WTUGordon/Smart_Car/其他材料/获奖证书.jpg

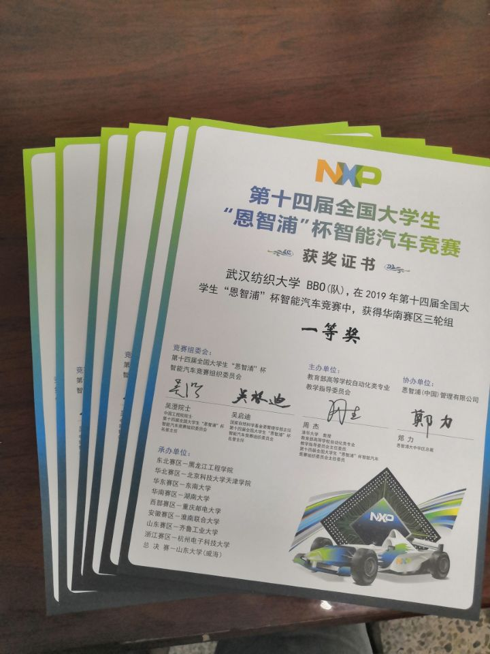
其他材料/获奖证书.jpg
