WTUGordon/Smart_Car/README.md

# Smart_Car
WTU BBO smart car 这个工程包括智能车的所有程序。
另外其他材料文件夹包括：材料清单、pcb原理图源文件、技术报告、获奖证书等。

BBO小队在恩智浦智能车第十四届比赛获得华南赛区一等奖。与国赛只相差一名，遗憾没能进入国赛。
