WTUGordon/Smart_Car/read me.txt

此工程模板由‘路径\... ...\山外K60参考代码V5.1（支持FX和DNZ）\第六章\DMA_鹰眼摄像头OV7725串口显示’ 更改。

App文件夹：存放着MK60的启动文件、总库、主函数、最底层驱动。不允许修改！
BBO文件夹：存放BBO写的头文件以及函数。
Board文件夹：存放所有外设硬件的驱动，有些是山外自带的，有些是从龙邱移植的。
Chip文件夹：存放K60单片机的所有功能模块的库，是野火山外的库。
Lib文件夹：内核头文件。
