WTUGordon/Smart_Car/Chip/src/MK66_i2c.c

/*!
 *     COPYRIGHT NOTICE
 *     Copyright (c) 2013,山外科技
 *     All rights reserved.
 *     技术讨论：山外论坛 http://www.vcan123.com
 *
 *     除注明出处外，以下所有内容版权均属山外科技所有，未经允许，不得用于商业用途，
 *     修改内容时必须保留山外科技的版权声明。
 *
 * @file       MK66_i2c.c
 * @brief      i2c驱动函数
 * @author     山外科技
 * @version    v6.0
 * @date       2013-07-12
 */

#include "common.h"
#include "MK66_port.h"
#include "MK66_i2c.h"
#include "include.h"

/*!
 *  @brief      I2C通信结束后需要调用的函数函数
 *  @since      v5.0
 *  @note       如果通信失败，可尝试增大此延时值，确认是否延时导致的
 */
void Pause(void)
{
    volatile uint16 n = 80;     //注意，这个数据太小，会导致读取错误。

    while(n--)
    {
        asm("nop");
    }
}

/******************************************************************************
*函  数：void delay_us(void)
*功　能：IIC延时
*参  数：无
*返回值：无
*备  注: 移植时只需要将delay_us()换成自己的延时即可
*******************************************************************************/
void delay_us(uint8_t us)
{
    for(int i = 0; i < 100; i++)
    {
        asm("NOP");//core bus 200M  情况下大概IIC速率 400K
    }
}

/******************************************************************************
*函  数：void IIC_Init(void)
*功　能：IIC初始化
*参  数：无
*返回值：无
*备  注：无
*******************************************************************************/
void IIC_Init(void)
{
    gpio_init(IIC_SCL_PIN,GPO,1);
    gpio_init(IIC_SDA_PIN,GPO,1);

	IIC_SCL=1;
	IIC_SDA=1;
}
/******************************************************************************
*函  数：void IIC_Start(void)
*功　能：产生IIC起始信号
*参  数：无
*返回值：无
*备  注：无
*******************************************************************************/
void IIC_Begin(void)
{
	SDA_O(); //sda线输出
	IIC_SDA=1;
	IIC_SCL=1;
	delay_us(4);
 	IIC_SDA=0; //START:when CLK is high,DATA change form high to low
	delay_us(4);
	IIC_SCL=0; //钳住I2C总线，准备发送或接收数据
}

/******************************************************************************
*函  数：void IIC_Stop(void)
*功　能：产生IIC停止信号
*参  数：无
*返回值：无
*备  注：无
*******************************************************************************/
void IIC_Cease(void)
{
	SDA_O(); //sda线输出
	IIC_SCL=0;
	IIC_SDA=0; //STOP:when CLK is high DATA change form low to high
    delay_us(4);
	IIC_SCL=1;
	IIC_SDA=1; //发送I2C总线结束信号
    delay_us(4);
}

/******************************************************************************
*函  数: uint8_t IIC_WaitAck(void)
*功　能: 等待应答信号到来 （有效应答：从机第9个 SCL=0 时 SDA 被从机拉低,
并且 SCL = 1时 SDA依然为低）
*参  数：无
*返回值：1，接收应答失败
0，接收应答成功
*备  注：从机给主机的应答
*******************************************************************************/
uint8_t IIC_WaitAck(void)
{
	uint8_t ucErrTime=0;
	SDA_I(); //SDA设置为输入  （从机给一个低电平做为应答）
	IIC_SDA=1;delay_us(1);
	IIC_SCL=1;delay_us(1);;
	while(READ_SDA)
	{
		ucErrTime++;
		if(ucErrTime>250)
		{
			IIC_Cease();
			return 1;
		}
	}
	IIC_SCL=0; //时钟输出0
	return 0;
}

/******************************************************************************
*函  数: void IIC_Ack(void)
*功　能: 产生ACK应答 （主机接收完一个字节数据后，主机产生的ACK通知从机一个
字节数据已正确接收）
*参  数：无
*返回值：无
*备  注：主机给从机的应答
*******************************************************************************/

void IIC_Ack(void)
{
	IIC_SCL=0;
	SDA_O();
	IIC_SDA=0;
	delay_us(1);
	IIC_SCL=1;
	delay_us(2);
	IIC_SCL=0;
}

/******************************************************************************
*函  数: void IIC_NAck(void)
*功　能: 产生NACK应答 （主机接收完最后一个字节数据后，主机产生的NACK通知从机
发送结束，释放SDA,以便主机产生停止信号）
*参  数：无
*返回值：无
*备  注：主机给从机的应答
*******************************************************************************/
void IIC_NAck(void)
{
	IIC_SCL=0;
	SDA_O();
	IIC_SDA=1;
	delay_us(1);
	IIC_SCL=1;
	delay_us(1);
	IIC_SCL=0;
}

/******************************************************************************
*函  数：void IIC_SendByte(uint8_t txd)
*功  能：IIC发送一个字节
*参  数：data 要写的数据
*返回值：无
*备  注：主机往从机发
*******************************************************************************/
void IIC_SendByte(uint8_t data)
{
    uint8_t t;
    SDA_O();
    IIC_SCL=0; //拉低时钟开始数据传输
    for(t=0;t<8;t++)
    {
        IIC_SDA=(data&0x80)>>7;
        data<<=1;
        delay_us(1);
        IIC_SCL=1;
        delay_us(1);
        IIC_SCL=0;
        delay_us(1);
    }
}

/******************************************************************************
*函  数：uint8_t IIC_ReadByte(uint8_t ack)
*功  能：IIC读取一个字节
*参  数：ack=1 时，主机数据还没接收完 ack=0 时主机数据已全部接收完成
*返回值：无
*备  注：从机往主机发
*******************************************************************************/
uint8_t IIC_ReadByte(uint8_t ack)
{
	uint8_t i,receive=0;
	SDA_I(); //SDA设置为输入模式 等待接收从机返回数据
    for(i=0;i<8;i++ )
	{
        IIC_SCL=0;
        delay_us(1);
        IIC_SCL=1;
        receive<<=1;
        if(READ_SDA)receive++; //从机发送的电平
        delay_us(1);
    }
    if(ack)
        IIC_Ack(); //发送ACK
    else
        IIC_NAck(); //发送nACK
    return receive;
}

/******************************************************************************
*函  数：uint8_t IIC_ReadByteFromSlave(uint8_t I2C_Addr,uint8_t addr)
*功　能：读取指定设备 指定寄存器的一个值
*参  数：I2C_Addr  目标设备地址
reg	     寄存器地址
*buf      读取数据要存储的地址
*返回值：返回 1失败 0成功
*备  注：无
*******************************************************************************/
uint8_t IIC_ReadByteFromSlave(uint8_t I2C_Addr,uint8_t reg,uint8_t *buf)
{
	IIC_Begin();
	IIC_SendByte(I2C_Addr);	 //发送从机地址
	if(IIC_WaitAck()) //如果从机未应答则数据发送失败
	{
		IIC_Cease();
		return 1;
	}
	IIC_SendByte(reg); //发送寄存器地址
	IIC_WaitAck();

	IIC_Begin();
	IIC_SendByte(I2C_Addr+1); //进入接收模式
	IIC_WaitAck();
	*buf=IIC_ReadByte(0);
    IIC_Cease(); //产生一个停止条件
	return 0;
}

/******************************************************************************
*函  数：uint8_t IIC_WriteByteFromSlave(uint8_t I2C_Addr,uint8_t addr，uint8_t buf))
*功　能：写入指定设备 指定寄存器的一个值
*参  数：I2C_Addr  目标设备地址
reg	     寄存器地址
buf       要写入的数据
*返回值：1 失败 0成功
*备  注：无
*******************************************************************************/
uint8_t IIC_WriteByteToSlave(uint8_t I2C_Addr,uint8_t reg,uint8_t data)
{
	IIC_Begin();
	IIC_SendByte(I2C_Addr); //发送从机地址
	if(IIC_WaitAck())
	{
		IIC_Cease();
		return 1; //从机地址写入失败
	}
	IIC_SendByte(reg); //发送寄存器地址
    IIC_WaitAck();
	IIC_SendByte(data);
	if(IIC_WaitAck())
	{
		IIC_Cease();
		return 1; //数据写入失败
	}
	IIC_Cease(); //产生一个停止条件

    //return 1; //status == 0;
	return 0;
}

/******************************************************************************
*函  数：uint8_t IICreadBytes(uint8_t dev, uint8_t reg, uint8_t length, uint8_t *data)
*功　能：读取指定设备 指定寄存器的 length个值
*参  数：dev     目标设备地址
reg	   寄存器地址
length  要读的字节数
*data   读出的数据将要存放的指针
*返回值：1成功 0失败
*备  注：无
*******************************************************************************/
uint8_t IIC_ReadMultByteFromSlave(uint8_t dev, uint8_t reg, uint8_t length, uint8_t *data)
{
    uint8_t count = 0;
	uint8_t temp;
	IIC_Begin();
	IIC_SendByte(dev); //发送从机地址
	if(IIC_WaitAck())
	{
		IIC_Cease();
		return 1; //从机地址写入失败
	}
	IIC_SendByte(reg); //发送寄存器地址
    IIC_WaitAck();
	IIC_Begin();
	IIC_SendByte(dev+1); //进入接收模式
	IIC_WaitAck();
    for(count=0;count<length;count++)
	{
		if(count!=(length-1))
            temp = IIC_ReadByte(1); //带ACK的读数据
		else
            temp = IIC_ReadByte(0); //最后一个字节NACK

		data[count] = temp;
	}
    IIC_Cease(); //产生一个停止条件
    //return count;
    return 0;
}

/******************************************************************************
*函  数：uint8_t IICwriteBytes(uint8_t dev, uint8_t reg, uint8_t length, uint8_t* data)
*功　能：将多个字节写入指定设备 指定寄存器
*参  数：dev     目标设备地址
reg	   寄存器地址
length  要写的字节数
*data   要写入的数据将要存放的指针
*返回值：1成功 0失败
*备  注：无
*******************************************************************************/
uint8_t IIC_WriteMultByteToSlave(uint8_t dev, uint8_t reg, uint8_t length, uint8_t* data)
{

 	uint8_t count = 0;
	IIC_Begin();
	IIC_SendByte(dev); //发送从机地址
	if(IIC_WaitAck())
	{
		IIC_Cease();
		return 1; //从机地址写入失败
	}
	IIC_SendByte(reg); //发送寄存器地址
    IIC_WaitAck();
	for(count=0;count<length;count++)
	{
		IIC_SendByte(data[count]);
		if(IIC_WaitAck()) //每一个字节都要等从机应答
		{
			IIC_Cease();
			return 1; //数据写入失败
		}
	}
	IIC_Cease(); //产生一个停止条件

	return 0;
}
