WTUGordon/Smart_Car/App/Inc/MK66_conf.h

/*!
 *     COPYRIGHT NOTICE
 *     Copyright (c) 2013,山外科技
 *     All rights reserved.
 *     技术讨论：山外论坛 http://www.vcan123.com
 *
 *     除注明出处外，以下所有内容版权均属山外科技所有，未经允许，不得用于商业用途，
 *     修改内容时必须保留山外科技的版权声明。
 *
 * @file       MK66_conf.h
 * @brief      山外K66 平台配置文件
 * @author     山外科技
 * @version    v6.0
 * @date       2017-11-04
 */

#ifndef __MK66_CONF_H__
#define __MK66_CONF_H__



/*
 * 定义平台[放在工程选项里定义]
 */
//#define  MK66F18


/*
 * 定义LCD型号
 */
#define LCD_ILI9341     0       //野火/秉火3.2寸大液晶
#define LCD_ST7735S     1       //LCD_ST7735S 与 LCD_ST7735R 外观一样，寄存器操作略有不同
#define LCD_ST7735R     2       //
#define LCD_ILI9325     3       //山外3.2寸大液晶




#define USE_LCD         LCD_ILI9325             //选择使用的 LCD


/*
 * 选择是否输出调试信息，不输出则注释下面的宏定义
 */
#define DEBUG_PRINT

/*
 * 定义晶振时钟，单位为MHz
 */
#define EXTAL_IN_MHz            (16)


/*
 * 定义 PLL 超频 频率 (不同的平台，有不同的超频配置)
 *
 * 如果对超频配置不熟悉，可以看如下帖子:
 * K60 KL26 主频和总线频率的关系 - 智能车资料区 - 山外论坛
 * http://www.vcan123.com/forum.php?mod=viewthread&tid=81&page=1&extra=#pid419
 */
#define CORE_CLK                PLL200      // 从 PLL_e 里选择 已提供的 配置方案
                                            // bus 、 flex bus 、 flash 频率 都是 core 整数倍分频而来
#define MAX_BUS_CLK             100         // bus      (bus        >= core/16  )
#define MAX_FLEXBUS_CLK         25          // flex bus (flex bus   >= core/16  )
#define MAX_FLASH_CLK           28          // flash    (flash      >= core/16  )


#define CORE_DIV          0         //  core = mcg/ ( CORE_DIV  + 1 )
#define BUS_DIV           1         //  bus  = mcg/ ( BUS_DIV   + 1 )
#define FLEX_DIV          9         //  flex = mcg/ ( FLEX_DIV  + 1 )
#define FLASH_DIV         8         //  flash= mcg/ ( FLASH_DIV + 1 )

/*
 * 定义 printf函数 的 串口输出端口 和 串口信息
 */
#define VCAN_PORT           UART3
#define VCAN_BAUD           115200

/*
 * 配置延时函数
 */
extern void    systick_delay(uint32 time);
extern void    systick_delay_ms(uint32 ms);
#if 0
#define DELAY()         dwt_delay_ms(500)
#define DELAY_MS(ms)    dwt_delay_ms(ms)
#define DELAY_US(us)    dwt_delay_us(us)
#elif   0
#define     DELAY()         lptmr_delay_ms(500)
#define     DELAY_MS(ms)    lptmr_delay_ms(ms)
#define     DELAY_US(us)    lptmr_delay_us(us)
#elif   0
#define DELAY()         pit_delay_ms(PIT3,500)
#define DELAY_MS(ms)    pit_delay_ms(PIT3,ms)
#define DELAY_US(us)    pit_delay_us(PIT3,us)
#elif   1
#define DELAY()         systick_delay_ms(500)
#define DELAY_MS(ms)    systick_delay_ms(ms)
#define DELAY_US(us)    systick_delay_us(us)
#else
extern void soft_delay_ms(uint32_t ms);
extern void soft_delay_us(uint32_t us);
#define DELAY()         soft_delay_ms(500)
#define DELAY_MS(ms)    soft_delay_ms(ms)
#define DELAY_US(us)    soft_delay_us(us)

#endif


/*
 * 配置断言和其实现函数
 */
void assert_failed(char *, int);

#if defined( DEBUG_MODE )
#define ASSERT(expr) \
    if (!(expr)) \
        assert_failed(__FILE__, __LINE__)
#else
#define ASSERT(expr)
#endif

/*
 * 配置调试输出函数
 */
#if( defined(DEBUG_MODE) && defined(DEBUG_PRINT))
#define DEBUG_PRINTF(FORMAT,...)        do{printf(FORMAT,##__VA_ARGS__);}while(0)	/*无需打印调试信息时，请将宏内容注释掉*/
#else
#define DEBUG_PRINTF(FORMAT,...)
#endif


#endif /* __MK66_CONF_H__  */
