WTUGordon/Smart_Car/Board/inc/LED.H

 /*!
  *     COPYRIGHT NOTICE
  *     Copyright (c) 2013,山外科技
  *     All rights reserved.
  *     技术讨论：山外论坛 http://www.vcan123.com
  *
  *     除注明出处外，以下所有内容版权均属山外科技所有，未经允许，不得用于商业用途，
  *     修改内容时必须保留山外科技的版权声明。
  *
  * @file       VCAN_LED.h
  * @brief      led驱动头文件
  * @author     山外科技
  * @version    v6.0
  * @date       2017-11-04
  */

#ifndef __LED_H__
#define __LED_H__


/*! 枚举LED编号 */
typedef enum
{
  LED0,
  LED1,
  LED2,
  LED3,
  LED_MAX,
}LED_e;

/*! 枚举LED亮灭状态 */
typedef enum LED_status
{
  LED_ON  =   0,            //灯亮(对应低电平)
  LED_OFF =   1             //灯暗(对应高电平)
}LED_status;


extern void    led_init(LED_e);            //初始化LED端口
extern void    led(LED_e,LED_status);      //设置LED灯亮灭
extern void    led_turn(LED_e);            //设置LED灯亮灭反转

#endif  //__VCAN_LED_H__
