WTUGordon/Smart_Car/Board/inc/key.h

/*!
 *     COPYRIGHT NOTICE
 *     Copyright (c) 2013,山外科技
 *     All rights reserved.
 *     技术讨论：山外初学论坛 http://www.vcan123.com
 *
 *     除注明出处外，以下所有内容版权均属山外科技所有，未经允许，不得用于商业用途，
 *     修改内容时必须保留山外科技的版权声明。
 *
 * @file       VCAN_KEY.h
 * @brief      KEY驱动头文件
 * @author     山外科技
 * @version    v5.0
 * @date       2013-07-10
 */

#ifndef __KEY_H__
#define __KEY_H__


//下面是定义按键的时间，单位为 ： 10ms（中断时间）
#define KEY_DOWN_TIME           1       //消抖确认按下时间
#define KEY_HOLD_TIME           50      //长按hold确认时间，最多253，否则需要修改 keytime 的类型
                                        //如果按键一直按下去，则每隔 KEY_HOLD_TIME - KEY_DOWN_TIME 时间会发送一个 KEY_HOLD 消息

//定义按键消息FIFO大小
#define KEY_MSG_FIFO_SIZE       20      //最多 255，否则需要修改key_msg_front/key_msg_rear类型

//按键端口的枚举
typedef enum
{
    SW_1,
    SW_2,

    SW_3,
    SW_4,



    KEY_1,  //上
    KEY_2,  //下

    KEY_3,  //左
    KEY_4,  //右

    KEY_MAX,


//
//    KEY_START,  //开始
//    KEY_STOP,   //停止

//    KEY_MAX,

    KEY_A,  //取消
    KEY_B,  //选择
} KEY_e;


//key状态宏定义
typedef enum
{
    KEY_DOWN  =   0,         //按键按下时对应电平
    KEY_UP    =   1,         //按键弹起时对应电平

    KEY_HOLD,

}  KEY_STATUS_e;

//按键消息结构体
typedef struct
{
    KEY_e           key;
    KEY_STATUS_e    status;
} KEY_MSG_t;


void            key_init(KEY_e key);            // KEY初始化函数(key 小于 KEY_MAX 时初始化 对应端口，否则初始化全部端口)
KEY_STATUS_e    key_check(KEY_e key);           //检测key状态（带延时消抖）
KEY_STATUS_e    key_get(KEY_e key);            //检测key状态（不带延时消抖）

//定时扫描按键
uint8   get_key_msg(KEY_MSG_t *keymsg);         //获取按键消息，返回1表示有按键消息，0为无按键消息
void    key_IRQHandler(void);                   //需要定时扫描的中断复位函数（定时时间为10ms）


#endif  //__VCAN_KEY_H__
