WTUGordon/Smart_Car/(notices)

Notices in the files:
Chip/inc/MK66_ftm.h:
Copyright (c) 2013,É½Íâ¿Æ¼¼
All rights reserved.
Board/src/LED.C:
Copyright (c) 2014,É½Íâ¿Æ¼¼
